kemot1709/Artificial_skin-thesis/Thesis/img/screen_rozklad.png

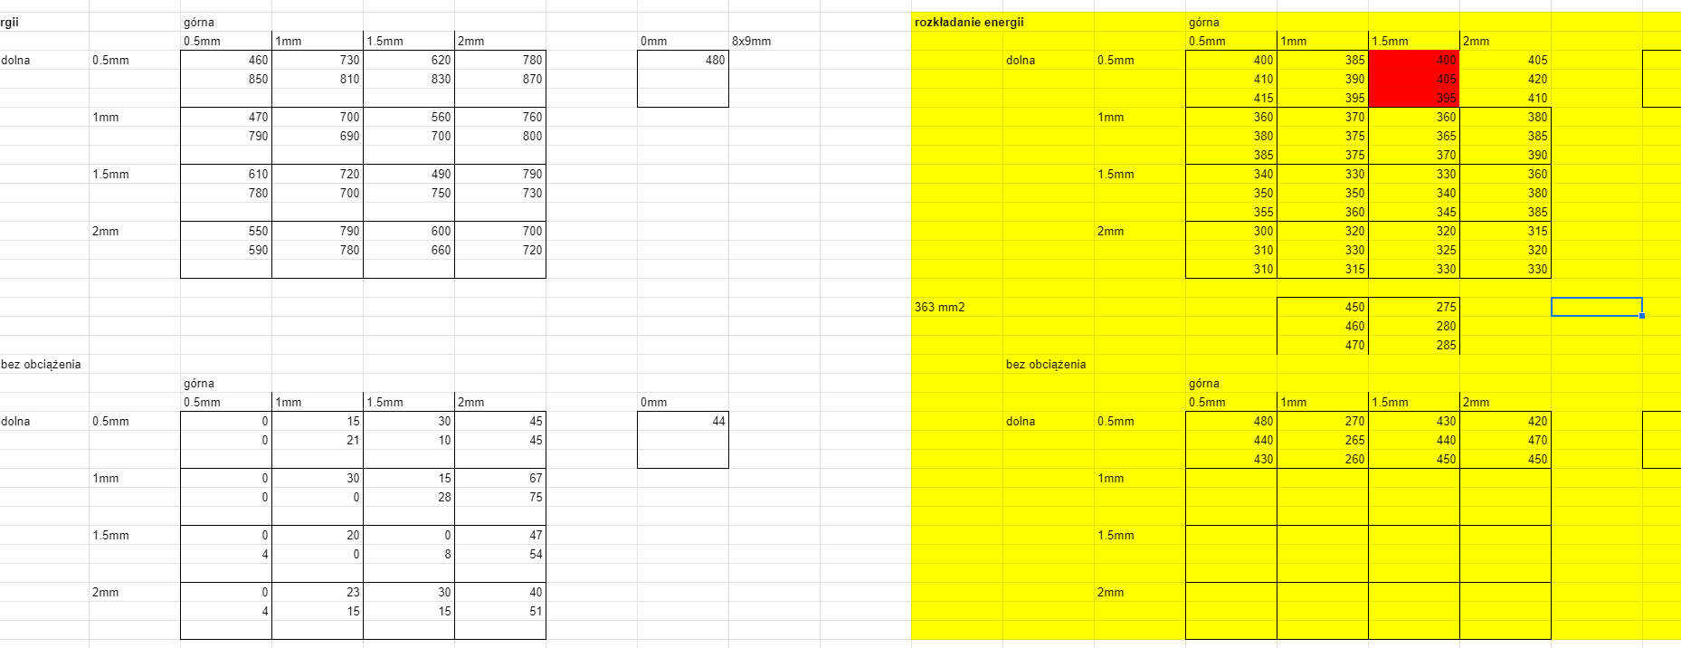
Thesis/img/screen_rozklad.png
