kemot1709/Artificial_skin-thesis/Thesis/img/test_okr_prace_2.jpg

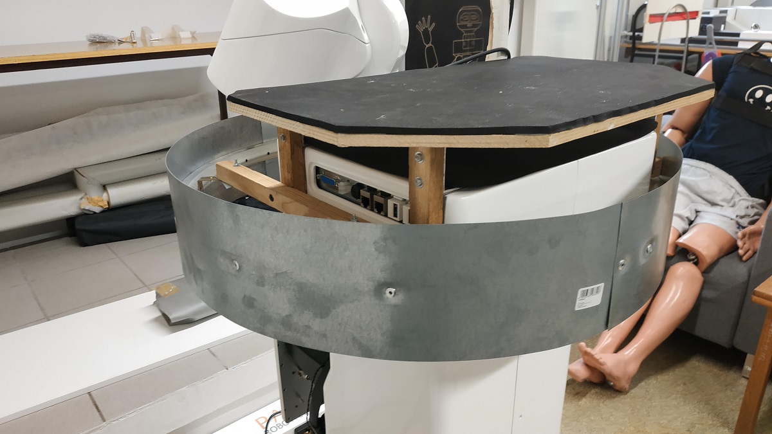
Thesis/img/test_okr_prace_2.jpg
