kemot1709/Artificial_skin-thesis/Thesis/img/test_okr_ready_1.jpg

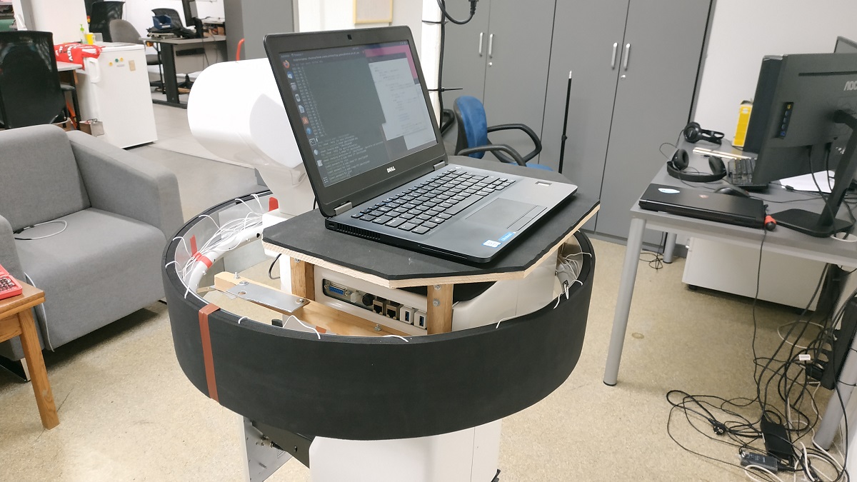
Thesis/img/test_okr_ready_1.jpg
