kemot1709/Artificial_skin-thesis/Documentation/driver_schematic.PDF

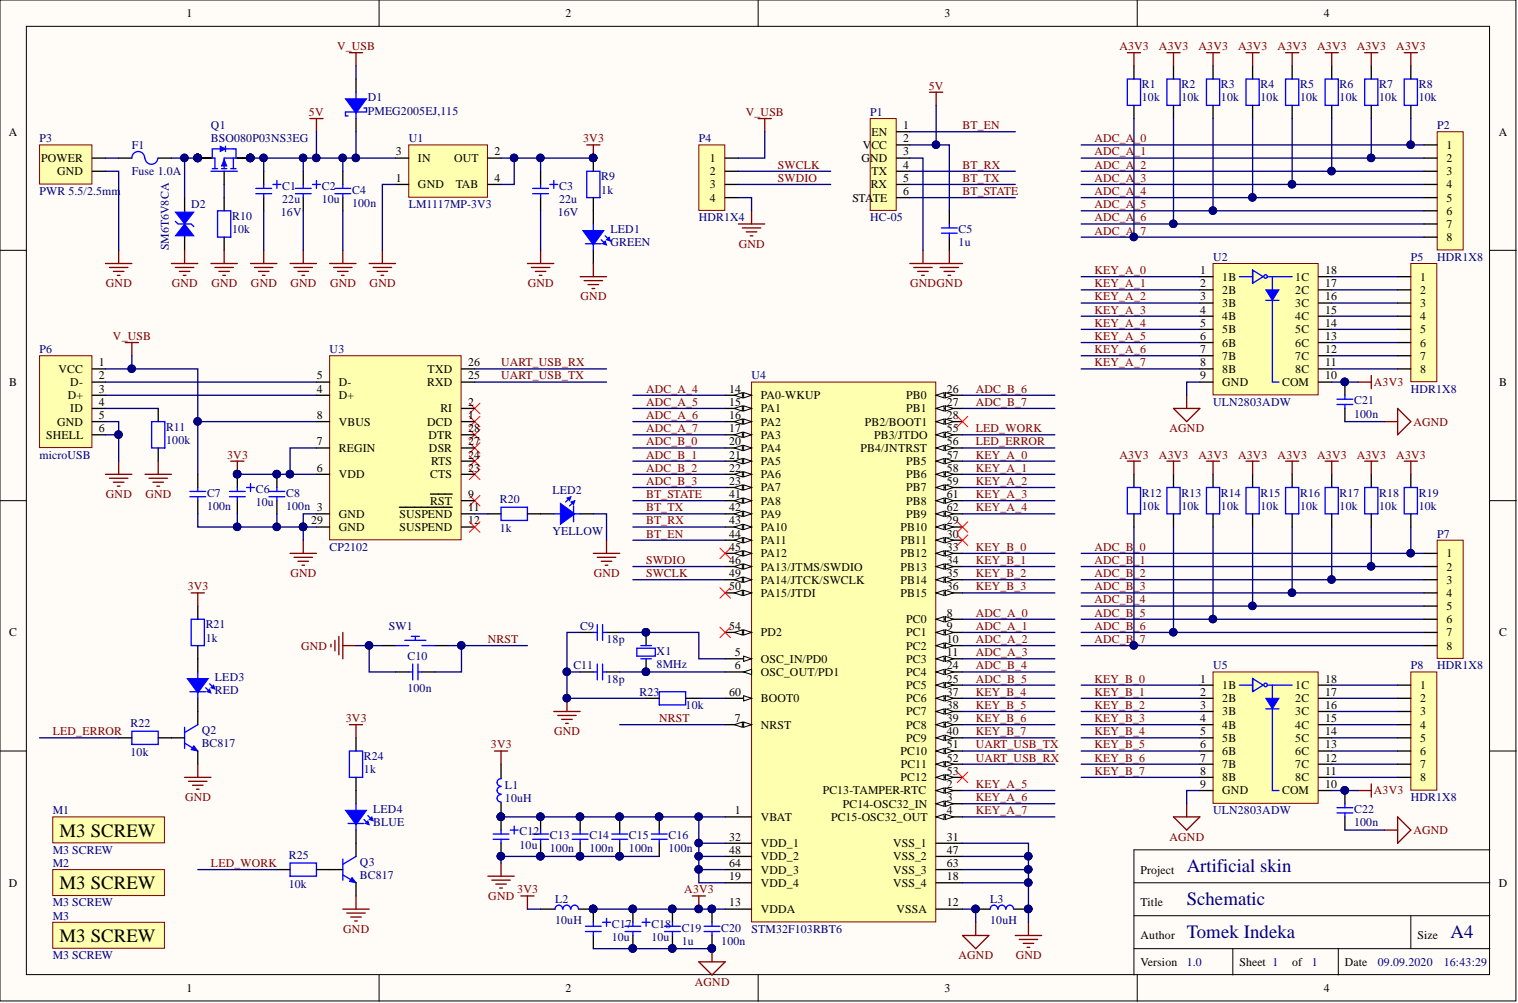
[picture p54: page 1]
